BASEL-GUBARA/MotorSpeedControl/MotorSpeedControl.jpg

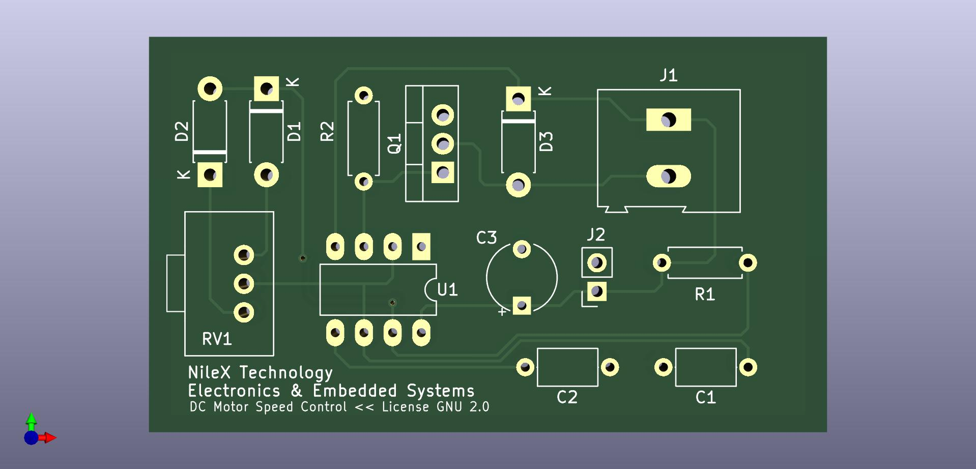
MotorSpeedControl.jpg
