BASEL-GUBARA/MotorSpeedControl/MotorSpeedControl.step

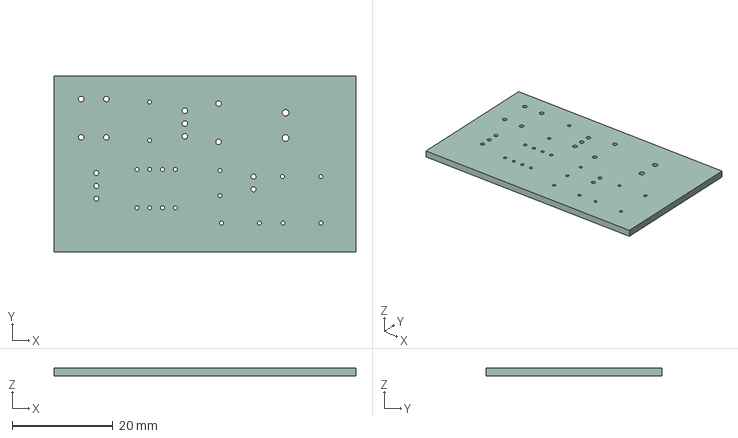
[picture p2: CAD file, 2023-12-29]
MotorSpeedControl.step
60.0 x 35.0 x 1.60 mm
