BASEL-GUBARA/MotorSpeedControl/MotorSpeedControl.kicad_pcb

## KiCad design MotorSpeedControl.kicad_pcb (2023-12-29)

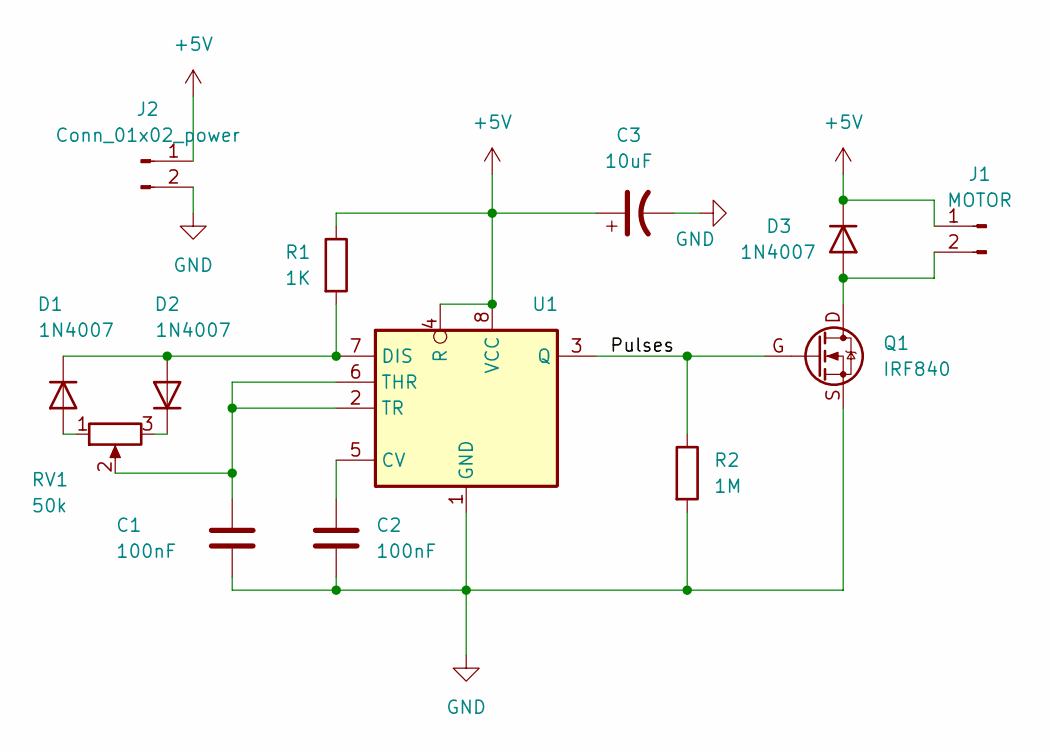
[picture p3: schematic MotorSpeedControl.kicad_sch, DC Motor Speed Control]

Parts:
C1, C2: 100nF; C_Axial_L5.1mm_D3.1mm_P7.50mm_Horizontal
C3: 10uF; CP_Radial_Tantal_D6.0mm_P5.00mm
D1, D2, D3: 1N4007; D_DO-41_SOD81_P7.62mm_Horizontal
J1: MOTOR; TerminalBlock_Altech_AK300-2_P5.00mm
J2: Conn_01x02_power; PinSocket_1x02_P2.54mm_Vertical
Q1: IRF840; TO-220-3_Vertical
R1: 1K; R_Axial_DIN0207_L6.3mm_D2.5mm_P7.62mm_Horizontal
R2: 1M; R_Axial_DIN0207_L6.3mm_D2.5mm_P7.62mm_Horizontal
RV1: 50k; Potentiometer_Vishay_248BH-249BH_Single_Horizontal
U1: DIP-8_W7.62mm_LongPads

Connections:
+5V: C3.1, D3.K, J1.1, J2.1, R1.1, U1.4 (R), U1.8 (VCC)
/Pulses: Q1.G, R2.1, U1.3 (Q)
GND: C1.2, C2.2, C3.2, J2.2, Q1.S, R2.2, U1.1 (GND)
unnamed: D1.A, RV1.1
unnamed: D2.K, RV1.3
unnamed: D3.A, J1.2, Q1.D
unnamed: C2.1, U1.5 (CV)
unnamed: D1.K, D2.A, R1.2, U1.7 (DIS)
unnamed: C1.1, RV1.2, U1.2 (TR), U1.6 (THR)

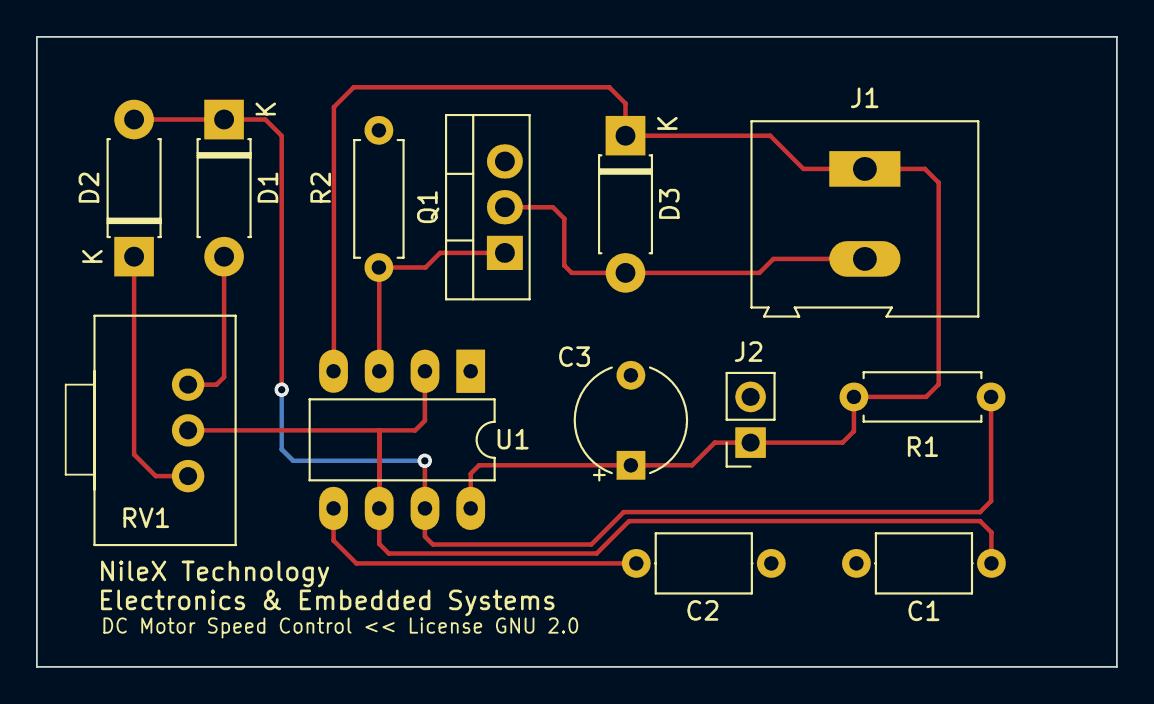
[picture p4: board MotorSpeedControl.kicad_pcb from above]

Board: 2 copper layers, 60.0 x 35.0 mm, 13 parts (0 on the bottom side), 9 nets.
